TheZoq2/LiTHe-Hex/README.md

#LiTHe Hex
Our project for the course TSEA29
