TheZoq2/LiTHe-Hex/documents/TekniskDokumentation/images/flowchart_sensor.png

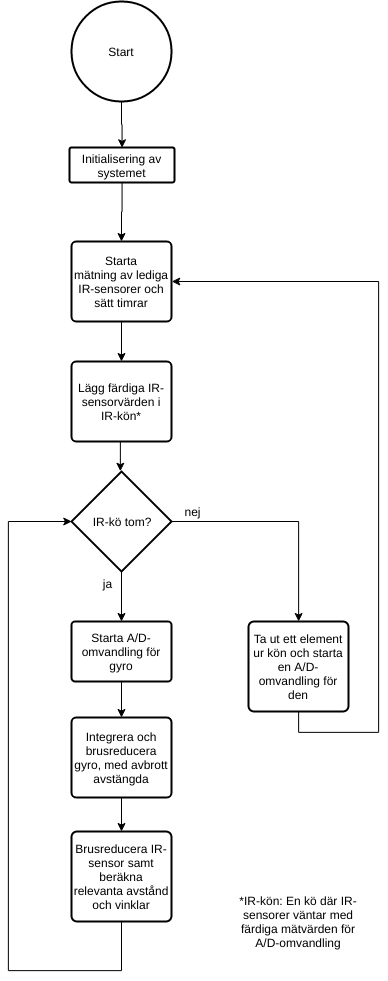
documents/TekniskDokumentation/images/flowchart_sensor.png
