TheZoq2/LiTHe-Hex/documents/TekniskDokumentation/images/IMG_20161005_120637.jpg

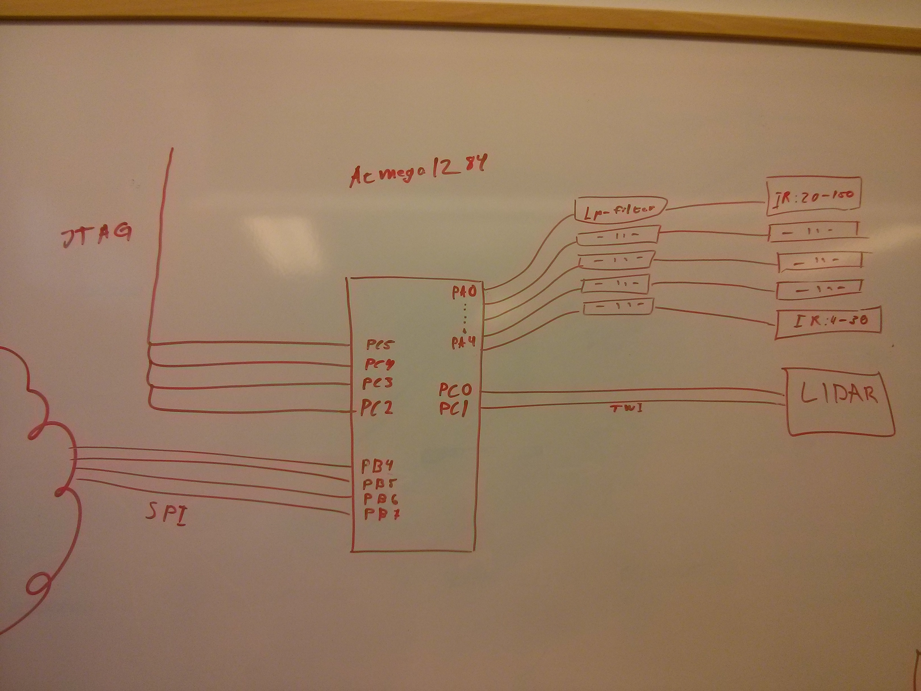
documents/TekniskDokumentation/images/IMG_20161005_120637.jpg
