TheZoq2/LiTHe-Hex/documents/TekniskDokumentation/images/IMG_20161006_112209.jpg

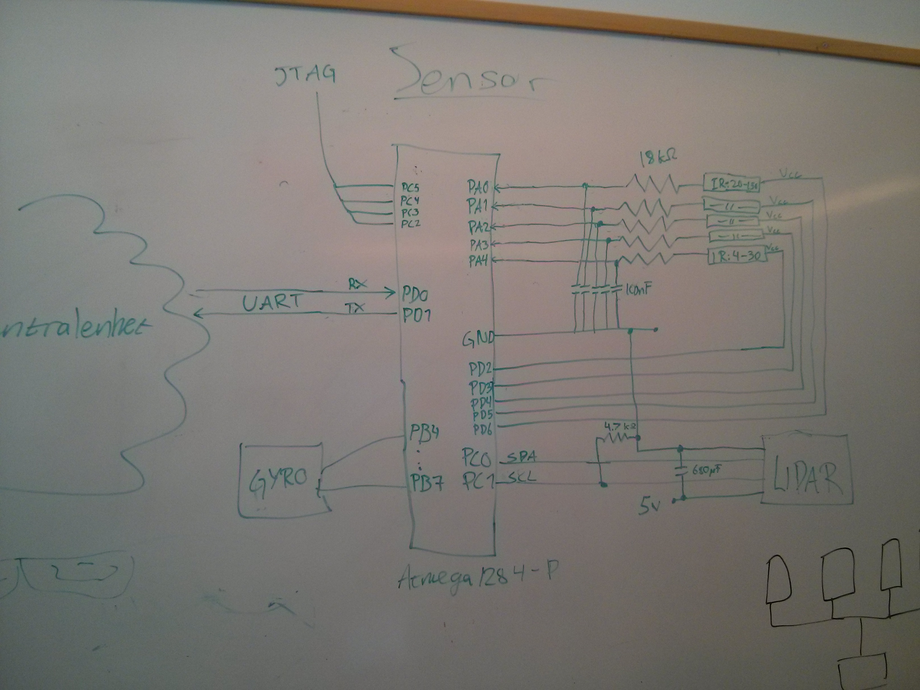
documents/TekniskDokumentation/images/IMG_20161006_112209.jpg
