TheZoq2/LiTHe-Hex/source/3d/alt sensormounts/sensormountFixed.stl

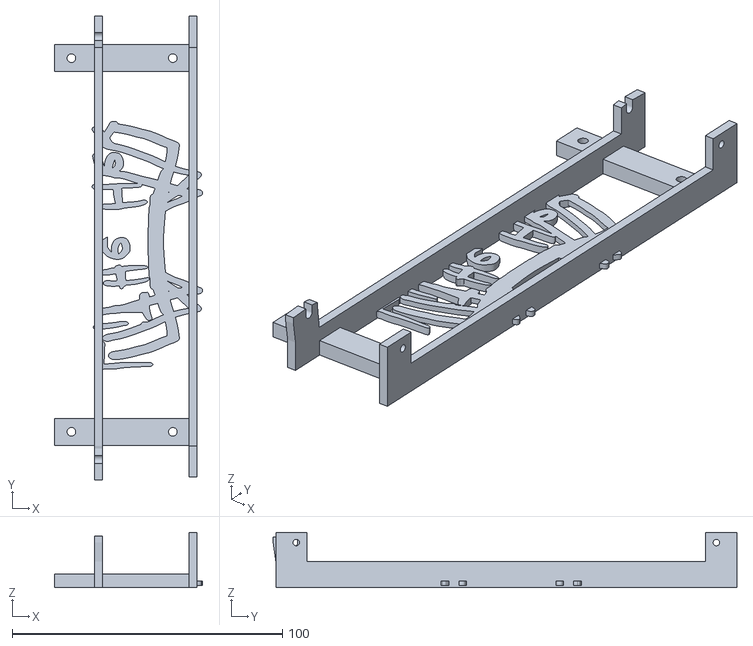
[picture p23: CAD file, 2016-12-06]
source/3d/alt sensormounts/sensormountFixed.stl
54.7 x 171.5 x 20.5
