TheZoq2/LiTHe-Hex/source/simulators/walk/media/cube.obj

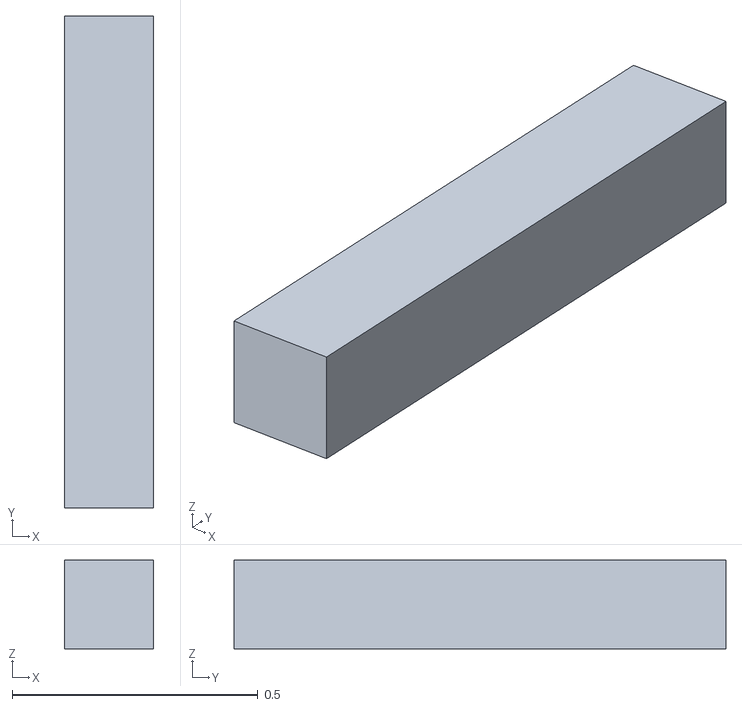
[picture p24: CAD file, 2016-10-11]
source/simulators/walk/media/cube.obj
0.181 x 1.00 x 0.181
