TheZoq2/LiTHe-Hex/source/3d/alt sensormounts/LOGO.stl

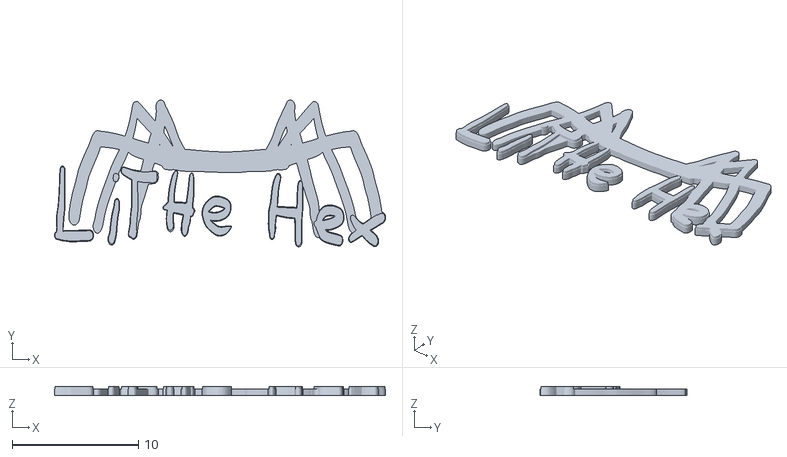
[picture p25: CAD file, 2016-12-06]
source/3d/alt sensormounts/LOGO.stl
26.2 x 11.6 x 0.7
