TheZoq2/LiTHe-Hex/source/3d/alt sensormounts/sensormount.obj

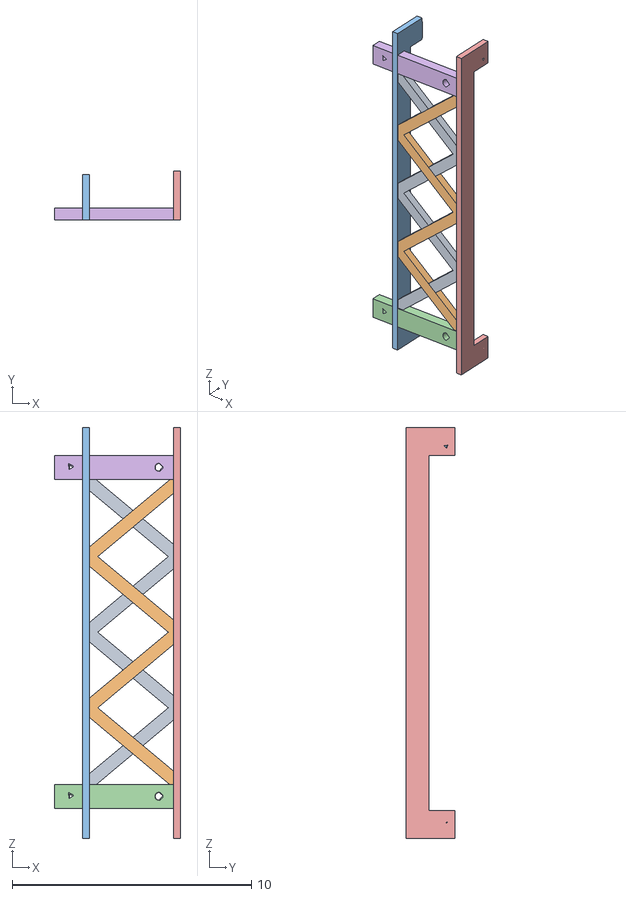
[picture p26: CAD file, 2016-11-30]
source/3d/alt sensormounts/sensormount.obj
5.28 x 2.05 x 17.2
Cube.001_Cube.003
Cylinder.003_Cylinder.002
Cylinder.002_Cylinder.003
