TheZoq2/LiTHe-Hex/(list of files, cad)

Other CAD files:
source/3d/alt sensormounts/sensormount.blend
