TheZoq2/LiTHe-Hex/documents/Anvandarmanual/anvman.tex

\documentclass[a4paper,titlepage,12pt]{article}
\usepackage[utf8]{inputenc} %Make sure all UTF8 characters work in the document
\usepackage{graphicx}
\usepackage{titling}
\usepackage{tabularx}
\usepackage{longtable}
\usepackage[yyyymmdd]{datetime}
\usepackage[figurename=Figur]{caption}
\usepackage{booktabs}
\usepackage[parfill]{parskip}
\usepackage{xcolor}
\usepackage{listings}
\usepackage{subcaption}

\lstdefinestyle{linux}
{
	backgroundcolor=\color{black},
	basicstyle=\scriptsize\color{white}\ttfamily
}

%Set page size
\usepackage{geometry}
\geometry{margin=3cm}

\renewcommand{\dateseparator}{-}
\renewcommand{\contentsname}{Innehållsförteckning}
\renewcommand{\tablename}{Tabell}

\usepackage{color}

\definecolor{dkgreen}{rgb}{0,0.6,0}
\definecolor{gray}{rgb}{0.5,0.5,0.5}
\definecolor{mauve}{rgb}{0.58,0,0.82}

\lstset{frame=tb,
  language=Python,
  aboveskip=3mm,
  belowskip=3mm,
  showstringspaces=false,
  columns=flexible,
  basicstyle={\small\ttfamily},
  numbers=none,
  numberstyle=\tiny\color{gray},
  keywordstyle=\color{blue},
  commentstyle=\color{dkgreen},
  stringstyle=\color{mauve},
  breaklines=true,
  breakatwhitespace=true,
  tabsize=3
}

%%%%%%%%%%%%%%%%%%%%%%%%%%%%%%%
% Header and footer
%%%%%%%%%%%%%%%%%%%%%%%%%%%%%%%
\usepackage{fancyhdr}
\pagestyle{fancy}

\lhead{}
\chead{Användarmanual för sexbent robot}
\rhead{\today}
\setlength\headheight{26pt} 

\lfoot{TSEA29 -- KMM \\ Användarmanual}
\rfoot{Grupp 9 \\ LiTHe Hex}

\newcommand{\itc}{I\textsuperscript{2}C}

\pretitle{%
	\begin{center}
		\LARGE
		\\[\bigskipamount]
}

\posttitle{\end{center}}

\begin{document}
	\title{\LARGE
		\textbf{Användarmanual för sexbent robot} \\
		\vspace*{0.5\baselineskip}
		\large
		Redaktör Frans Skarman \\
		Grupp 9 \\
		\small
		\vspace*{0.5\baselineskip}
		Version 1.0}

	\date{\today}

	\maketitle
	
	\newpage

	\tableofcontents
	\newpage

	%%%%%%%%%%%%%%%%%%%%%%%%%%%%%%%%%%%%%%%%%%%%%%%%%%%%%%%%%%%%%%%%%%%%%%%%%%%%%%%%%
	%						Historik
	%%%%%%%%%%%%%%%%%%%%%%%%%%%%%%%%%%%%%%%%%%%%%%%%%%%%%%%%%%%%%%%%%%%%%%%%%%%%%%%%%

	\section*{Dokumenthistorik}
	\renewcommand*{\arraystretch}{1.4}
    \begin{longtable}[c]{ l l >{\raggedright}p{5cm} >{\raggedright}p{3cm} l }
		\textbf{Version} & \textbf{Datum} & \textbf{Utförda förändringar} 
		& \textbf{Utförda av} & \textbf{Granskad} \\ \midrule
		
	    1.0 & 2016--12--14 & Första versionen & Projektgruppen &
        Projektgruppen \\
            
	\end{longtable}

	%%%%%%%%%%%%%%%%%%%%%%%%%%%%%%%%%%%%%%%%%%%%%%%%%%%%%%%%%%%%%%%%%%%%%%%%%%%%%%%%%
	%						Inledning
	%%%%%%%%%%%%%%%%%%%%%%%%%%%%%%%%%%%%%%%%%%%%%%%%%%%%%%%%%%%%%%%%%%%%%%%%%%%%%%%%%

	\newpage

	\raggedright

	\section{Inledning}
	Detta dokument beskriver användningen av LiTHe Hex magnifika sexbenta robot.

	%%%%%%%%%%%%%%%%%%%%%%%%%%%%%%%%%%%%%%%%%%%%%%%%%%%%%%%%%%%%%%%%%%%%%%%%%%%%%%%%%
	%						Översikt
	%%%%%%%%%%%%%%%%%%%%%%%%%%%%%%%%%%%%%%%%%%%%%%%%%%%%%%%%%%%%%%%%%%%%%%%%%%%%%%%%%
	
	\section{Roboten}
    Vid påslag av strömmen startar roboten alla system automatiskt.
    På roboten finns en knapp med vilken man kan byta mellan autonomt och
    manuellt läge.

	%%%%%%%%%%%%%%%%%%%%%%%%%%%%%%%%%%%%%%%%%%%%%%%%%%%%%%%%%%%%%%%%%%%%%%%%%%%%%%%%%
	%						Grafiskt användargränssnitt
	%%%%%%%%%%%%%%%%%%%%%%%%%%%%%%%%%%%%%%%%%%%%%%%%%%%%%%%%%%%%%%%%%%%%%%%%%%%%%%%%%

	\section{Grafiskt användargränssnitt}
	Här beskrivs hur man använder det grafiska användargränssnittet för roboten.
	
	\subsection{Starta webbservern}
    I vanliga fall ska webbservern på pi:en startas automatiskt av ett skript.
    I annat fall kan man göra det manuellt.
	Man startar servern genom att gå till mappen "/var/www/gui/" och skriva "mix
    phoenix.server". Se exempel nedan:
	
	\begin{lstlisting}[style=linux]
	/var/www/gui>> mix phoenix.server
	\end{lstlisting}
	
	\subsection{Ansluta till webbsidan}
	Servern startas på port 4000 och för att komma till webbsidan behöver man
    också pi:ens ip-adress. För att ta reda på Raspberry pi:ens ip-adress kan man gå in
    på telegram-kanalen https://telegram.me/lithehexbot. Det kräver dock att
    man har ett telegram-konto.
	
	Vi antar att ip-adressen är 127.0.0.1 och då skulle man i adressfältet i
    webbläsaren skriva 127.0.0.1:4000 för att komma till webbsidan.
    
    % TODO Är detta korrekt nedan?
    Det finns möjlighet att koppla in Raspberry pi till en skärm för att på så sätt ta reda på 
    vilken ip-adress som den har. 
	
	När man har anslutit till webbsidan finns det två olika flikar man kan välja
    mellan: Control och Debug. De beskrivs nedan i \ref{gui:control} och
    \ref{gui:debug}. Control är den första sidan som öppnas.
    \newpage
	
	\subsection{Control}\label{gui:control}
	\begin{figure}[h]
      \centering
      \begin{subfigure}{.4\textwidth}
        \centering
		
        \caption{Styrning för det manuella läget}
      \end{subfigure}
      \begin{subfigure}{.4\textwidth}
        \centering
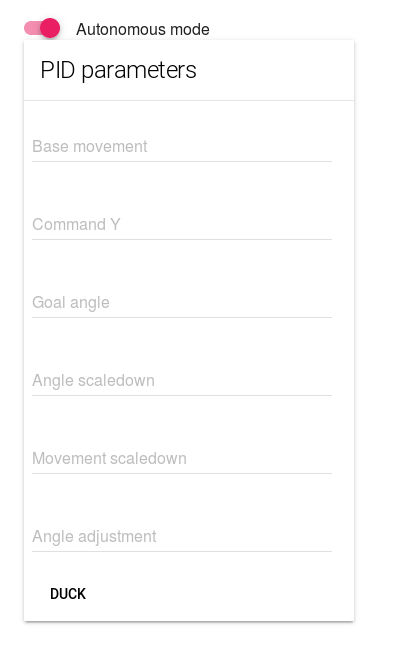
[picture p27: documents/Anvandarmanual/images/gui-parameters.png]
		
		\caption{Parametrar för det autonoma läget}
      \end{subfigure}
      \caption{Det grafiska gränssnittet för control\label{fig:gui-control}}
	\end{figure}
	
	När man har öppnat controlsidan antas det att en joystick är inkopplad i
    datorn. Om det finns en joystick inkopplad så kan man styra roboten med den.
    Om man drar joysticken åt ett håll rör sig roboten i den riktningen. En
    rotation av joysticken kommer göra att roboten roterar. På joysticken
    finns också ett gasreglage som styr hur snabbt roboten går och en
    återställningsknapp som gör att roboten återgår till sitt ursprungsläge och
    ställer sig upp igen.

    Om man inte har en joystick finns det olika reglage på skärmen man själv kan
    ändra: X- och Y-led, rotation samt thrust.
	
	Det finns en knapp som heter stop som stoppar roboten. Längst upp finns
    också en knapp för att välja mellan autonomt och manuellt läge. Manuellt
    läge är standardvärde. Se figur \ref{fig:gui-control} för att se hur webbsidan
    ser ut.
	
    \newpage
	\subsection{Debug}\label{gui:debug}
	\begin{figure}[h]
		\centering
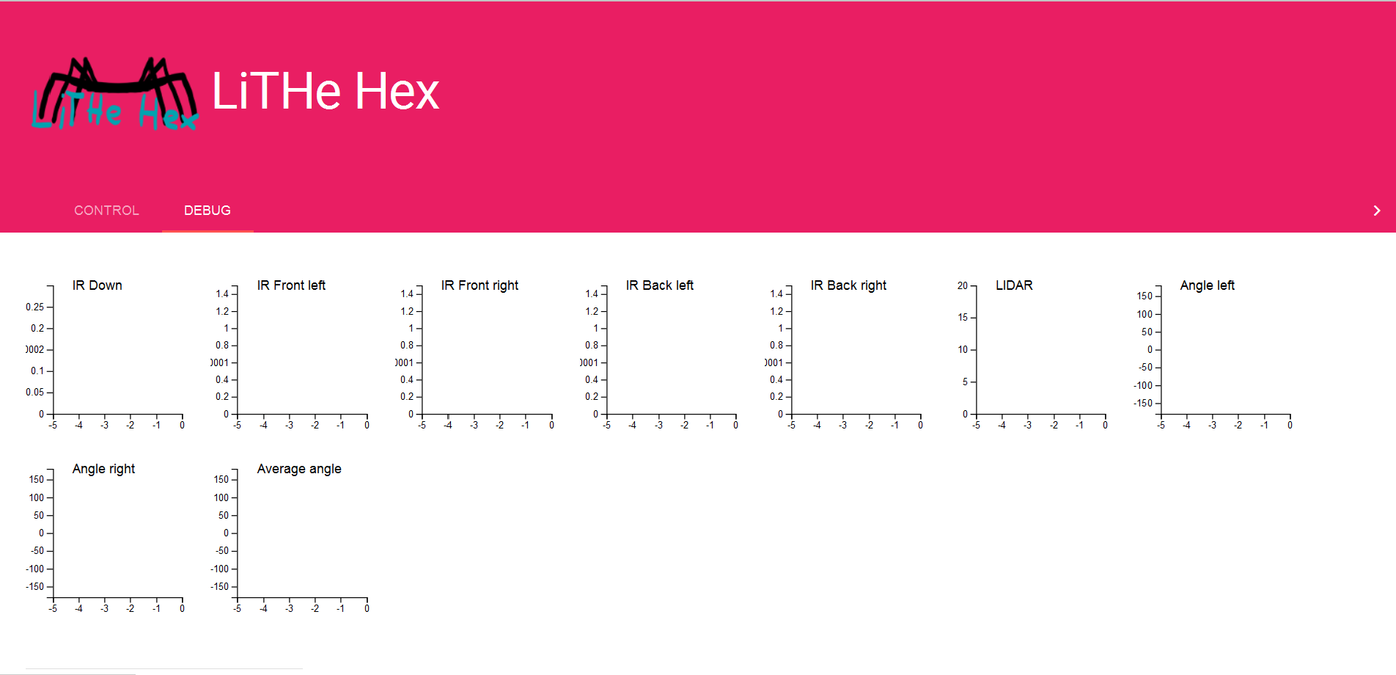
[picture p28: documents/Anvandarmanual/images/gui-debug.png]
		
		\caption{Det grafiska gränssnittet för control\label{fig:gui-debug}}
	\end{figure}
	När man öppnat debug fliken på hemsidan finns det nio stycken olika grafer som visar 
    olika sensordata för roboten vid det här tillfället. Graferna uppdateras tio
    gånger i sekunden för de nya värden som kommer in. Se figur
    \ref{fig:gui-debug} för hur debugsidan ser ut.
	
	% TODO: Ta med om man behöver uppdatera t.ex. phoenix eller liknande?

\end{document}
