TheZoq2/LiTHe-Hex/documents/Anvandarmanual/images/gui-front.png

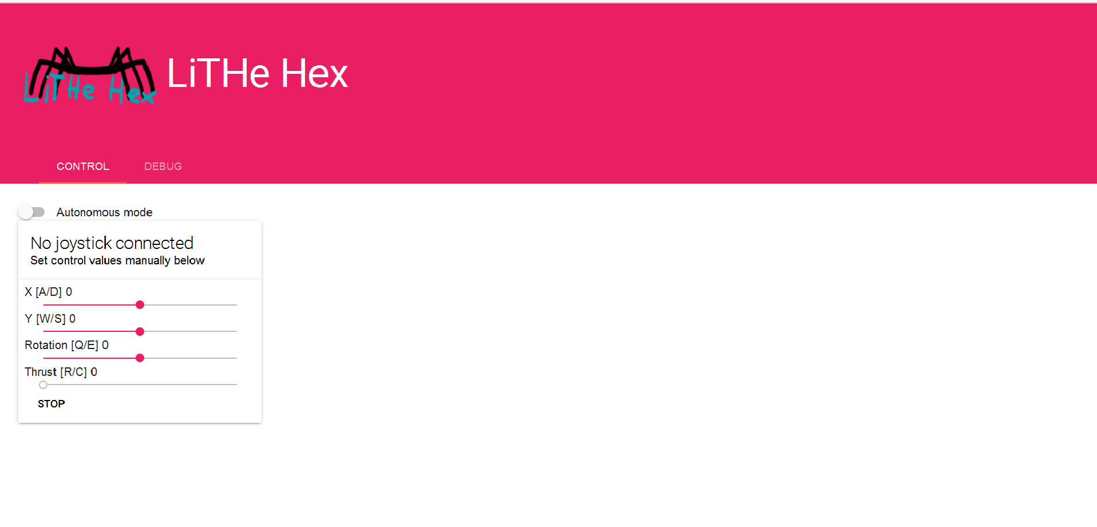
documents/Anvandarmanual/images/gui-front.png
