TheZoq2/LiTHe-Hex/source/sensor/measurements/measurements_ir.xlsx

Längd (cm) | Värde |  |  |  |  | Medel
20 | 505 | 510 | 505 | 510 | 504 | 506.8
30 | 390 | 395 | 394 | 391 | 391 | 392.2
40 | 300 | 301 | 300 | 303 | 300 | 300.8
50 | 239 | 243 | 246 | 246 | 243 | 243.4
60 | 207 | 207 | 209 | 204 | 200 | 205.4
70 | 173 | 174 | 176 | 173 | 174 | 174
80 | 152 | 156 | 155 | 152 | 152 | 153.4
90 | 136 | 140 | 135 | 135 | 140 | 137.2
100 | 126 | 122 | 126 | 121 | 127 | 124.4
110 | 113 | 112 | 113 | 112 | 112 | 112.4
120 | 105 | 104 | 103 | 104 | 104 | 104
130 | 97 | 96 | 95 | 95 | 95 | 95.6
140 | 89 | 87 | 87 | 86 | 88 | 87.4
150 | 83 | 83 | 83 | 85 | 83 | 83.4
Längd (cm) | Värde |  |  |  |  | Medel
4 | 551 | 550 | 550 | 559 | 549 | 551.8
6 | 406 | 399 | 399 | 405 | 406 | 403
8 | 315 | 310 | 310 | 315 | 311 | 312.2
10 | 235 | 252 | 252 | 257 | 252 | 249.6
12 | 210 | 210 | 209 | 210 | 212 | 210.2
14 | 179 | 179 | 179 | 186 | 179 | 180.4
16 | 155 | 159 | 156 | 159 | 159 | 157.6
18 | 140 | 142 | 143 | 140 | 141 | 141.2
20 | 122 | 123 | 123 | 123 | 123 | 122.8
22 | 112 | 112 | 111 | 111 | 111 | 111.4
24 | 103 | 105 | 103 | 103 | 103 | 103.4
26 | 91 | 95 | 89 | 93 | 92 | 92
28 | 88 | 87 | 89 | 89 | 89 | 88.4
30 | 79 | 76 | 81 | 79 | 76 | 78.2
 |  | 234
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
