TheZoq2/LiTHe-Hex/(threads)

Thread 14 (2016-11-30):

Impossible coordinates to IK should be dealt with

TheZoq2, 2016-11-30:

Kahiron, 2016-11-30:
@TheZoq2 If current code requests positions outside the reach of leg, adjusting constant MAX_DIST in gangstil should be sufficient to prevent this.

Closed 2016-11-30.

Thread 18 (2016-12-06):

Motor unit probably needs to reset rotation command after rotation.

malcx95, 2016-12-06:
Might rotate indefinitely otherwise.

Closed 2017-06-01.

Thread 19 (2016-12-11):

Things to try to get rid of SPI issues

TheZoq2, 2016-12-11:
- Disconnect servos (they caused issues before)
- Set CS enabled constantly (Might cause the transmission to fail because of weird hardware)
- Disconnect the sensors
- Disconnect all sensor hardware from sensor AVR (since avr disconnection solves the problem)
- Pull-up resistors on CS
- Check the datasheet for details on what the LVL shifter does with high-impedance and correct datadirection. (make sure it's connected propperly)

Debugging ideas
---
- Measure the voltage when everything is connected < 5V?
- Turn off some software things in the sensor unit

Closed 2016-12-12.
