TheZoq2/LiTHe-Hex/documents/Designspecifikation/images/flowchart_sensor.pdf

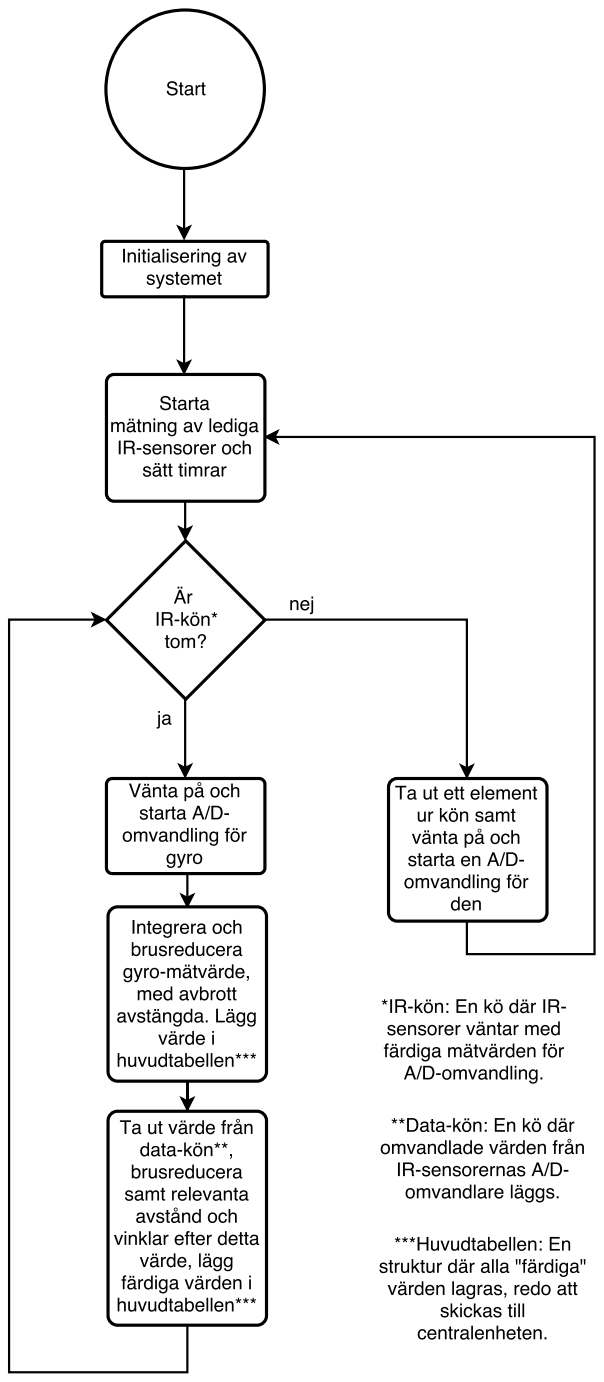
[picture p30: page 1]
