TheZoq2/LiTHe-Hex/documents/TekniskDokumentation/images/sensor_mount.pdf

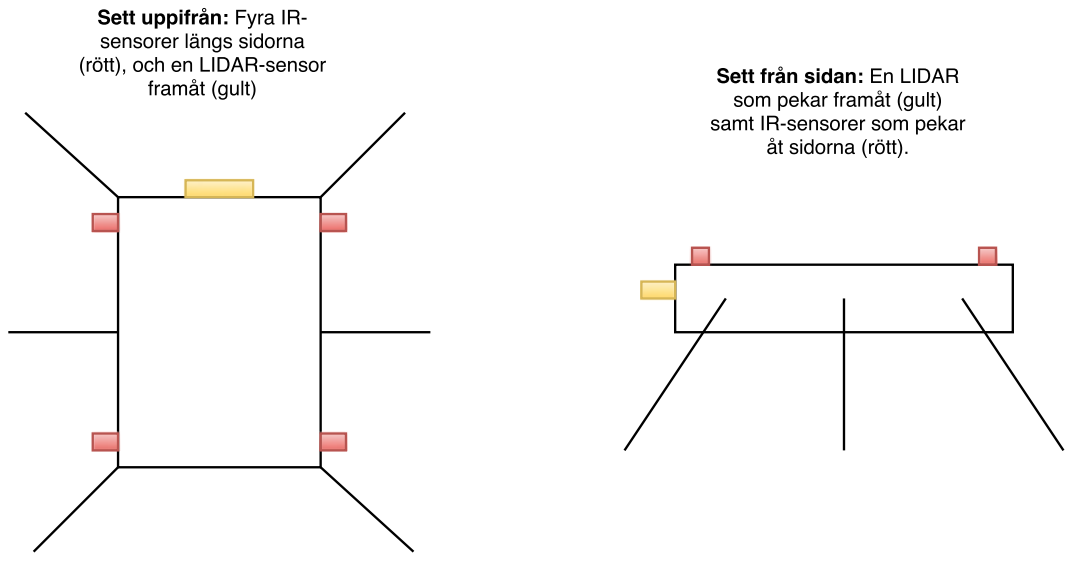
[picture p31: page 1]
