TheZoq2/LiTHe-Hex/documents/TekniskDokumentation/charts/central/centralenhet.pdf

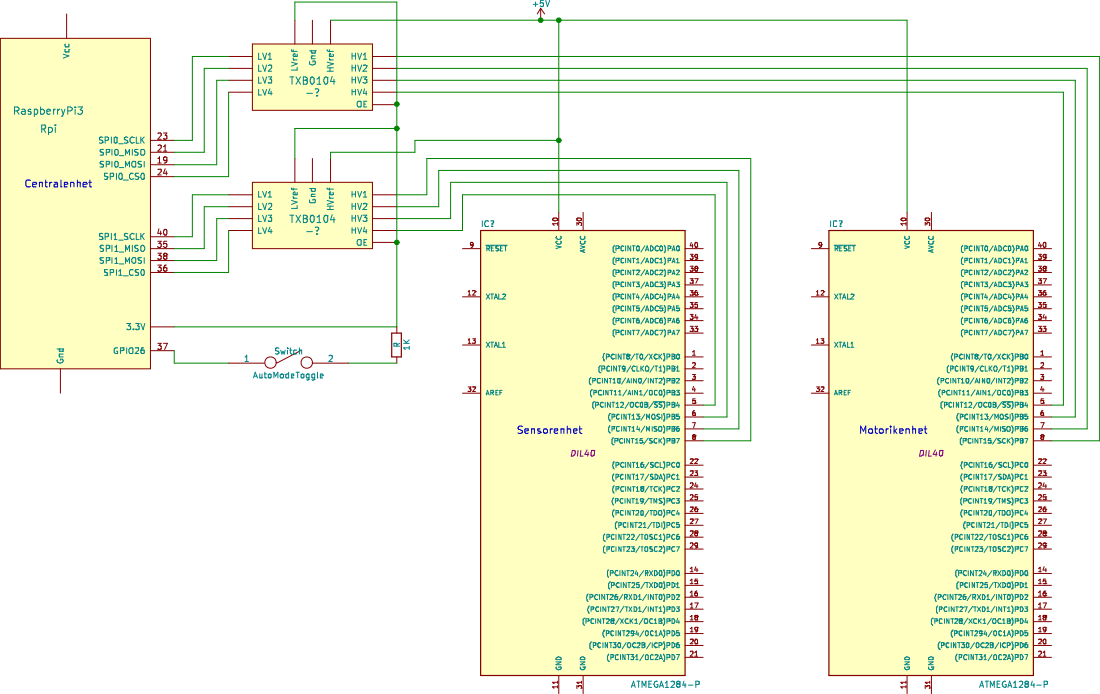
[picture p32: page 1]
