TheZoq2/LiTHe-Hex/documents/TekniskDokumentation/charts/sensor/sensor.pdf

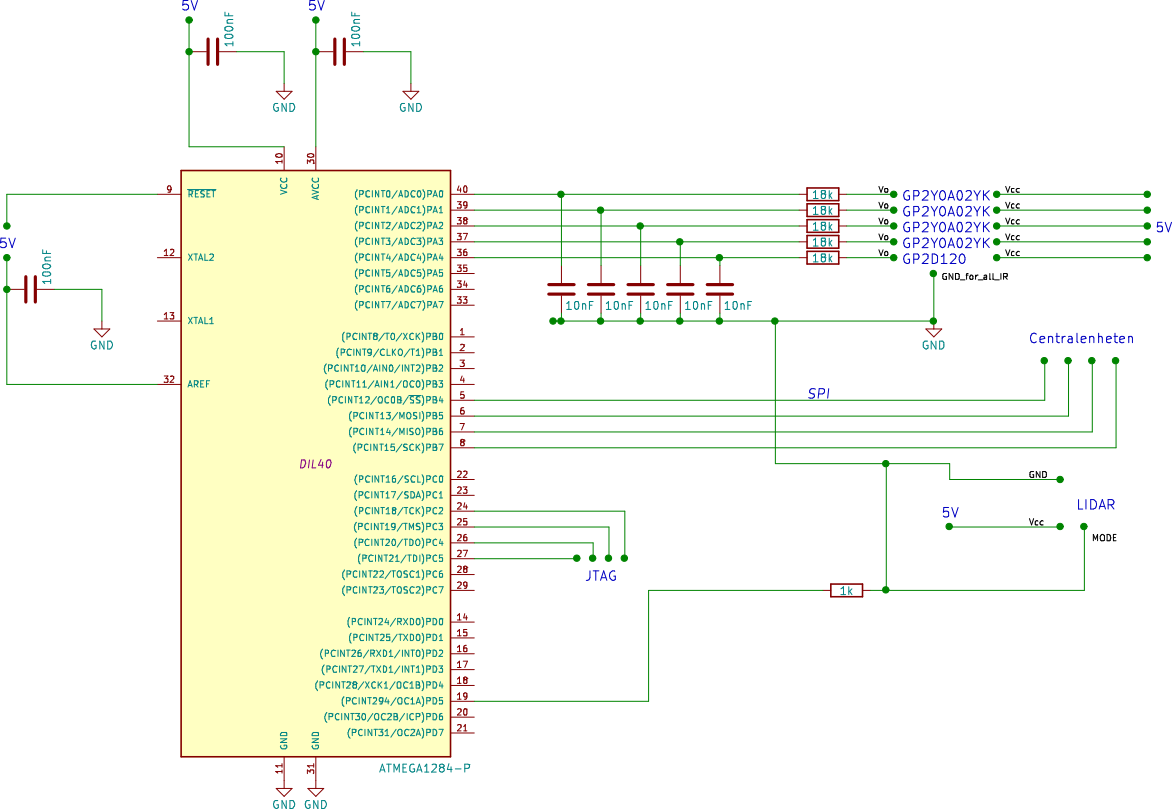
[picture p33: page 1]
