TheZoq2/LiTHe-Hex/documents/TekniskDokumentation/charts/motor/motorik.pdf

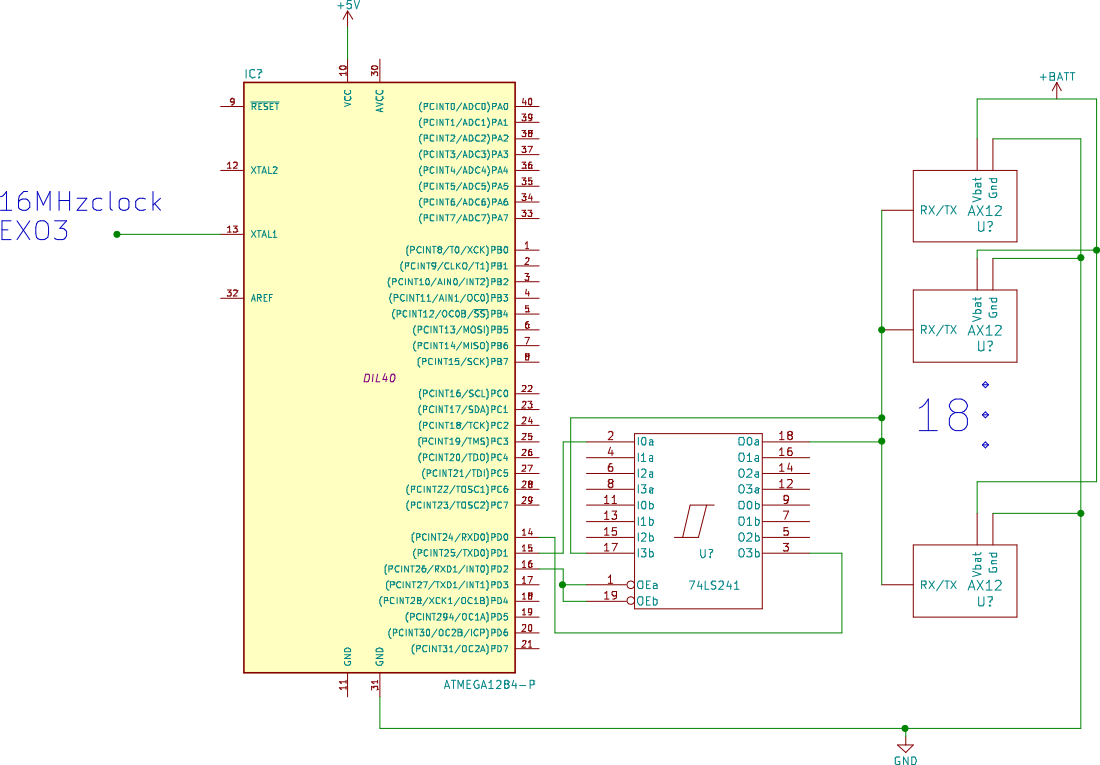
[picture p34: page 1]
