TheZoq2/LiTHe-Hex/source/central_unit/communication/avr_communication.py

# Copyright 2016 Noak Ringman, Emil Segerbäck, Robin Sliwa, Frans Skarman, Hannes Tuhkala, Malcolm Wigren, Olav Övrebö
#

# This file is part of LiTHe Hex.

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
"""
Module for handling communication with the sensor and motor units.
"""

try:
    import spidev
except ImportError:
    import tests.fake_spi as spidev

import time
import math
import angle_calculation
import pdb
import constants


MOTOR_ADDR = (0, 0)
SENSOR_ADDR = (1, 0)

DATA_REQ    = 0x02

SEND_FAIL   = 0x1F
ACK         = 0x0F
GARBAGE     = 0x00

BUSY_ROTATING = 0x03

SET_SERVO_SPEED = 0x20
SET_SERVO_SPEED_LENGTH = 2

WALK = 0x21
WALK_LENGTH = 4

RETURN_TO_NEUTRAL = 0x05

SERVO_STATUS = 0x22
MOTOR_DEBUG = 0x23

SENSOR_DATA = 0x24


class InvalidCommandException(Exception):

    def __init__(self, message, command=""):
        self.message = message
        self.command = command

    def __repr__(self):
        return self.message

    def __str__(self):
        return self.message


class CommunicationError(Exception):

    def __init__(self, message, cause=None):
        self.message = message
        self.cause = cause

    def __repr__(self):
        return self.message

    def __str__(self):
        return self.message


class SensorDataPacket(object):
    """
    Data structure containing the values of all sensors. All angles
    are measured in degrees and all distances in meters.
    """

    def __init__(self, ir_down, ir_front_left, ir_back_left,
                 ir_front_right, ir_back_right, lidar_msd, lidar_lsd):
        # divide by hundred to convert from cm -> m
        self.ir_front_left  = ir_front_left / 100
        self.ir_front_right = ir_front_right / 100
        self.ir_back_left   = ir_back_left / 100
        self.ir_back_right  = ir_back_right / 100
        self.ir_down        = ir_down / 100
        self.lidar          = (lidar_lsd | (lidar_msd << 8)) / 100
        self.left_angle     = angle_calculation.get_left_angle(self)
        self.right_angle    = angle_calculation.get_right_angle(self)
        self.average_angle  = angle_calculation.get_average_angle(self)

    def __str__(self):
        return """
Front left:  {}
Front right: {}
Back left:   {}
Back right:  {}
Down:        {}
Lidar:       {}
                """.format(
                        self.ir_front_left,
                        self.ir_front_right,
                        self.ir_back_left,
                        self.ir_back_right,
                        self.ir_down,
                        self.lidar)


def _calculate_parity(data):
    data_str = "{0:032b}".format(data)
    num_ones = data_str.count("1")
    if num_ones % 2 == 0:
        return 0
    else:
        return 1


def _add_parity(type_, msg):
    msg_parity = _calculate_parity(msg)
    result = type_ << 2
    result |= msg_parity << 1
    type_parity = _calculate_parity(result)
    result |= type_parity
    return result


def _send_bytes(spi, *data):
    # check if all are bytes
    if sum([(not isinstance(x, int)) or x > constants.MAX_BYTE_SIZE or x < 0 for x in data]):
        raise InvalidCommandException("Data sequence {} contains non-bytes".format(data))
    spi.writebytes([GARBAGE])
    spi.writebytes(list(data))
    return spi.readbytes(1)


def _recieve_muliple_bytes(spi, type_):
    length = spi.readbytes(1)[0]
    return spi.readbytes(length)


def _recieve_single_byte(spi, type_):
    return spi.readbytes(1)


def _recieve_bytes(spi):
    type_ = spi.readbytes(1)[0]

    # if the most significant bit in the
    # type message is 1, then the message
    # is of variable length
    if _is_multibyte_msg(type_):
        return _recieve_muliple_bytes(spi, type_)
    else:
        return _recieve_single_byte(spi, type_)


def _is_multibyte_msg(data_id):
    return (data_id & 0x80) != 0


def _request_data(spi, data_id):
    # response = spi.xfer2([DATA_REQ, data_id])
    # pdb.set_trace()
    response = _send_bytes(spi, _add_parity(DATA_REQ, data_id), data_id)
    _check_response(response)
    return _recieve_bytes(spi)


# def _select_device(spi, addr):
#     spi.open(*addr)
# 
# 
# def _deselect_device(spi):
#     spi.close()


def _check_response(response):
    if isinstance(response, list):
        _check_response(response[0])
    elif response == SEND_FAIL:
        raise CommunicationError("Send fail received")
    elif response != ACK:
        raise CommunicationError("No acknowledge message received")


def _get_total_msg(*data):
    length = len(data)
    res = ""
    for d in data:
        res += "{0:08b}".format(d)
    return int(res, 2)


def sensor_communication_init():
    """
    Initializes the SPI-communication to the
    sensor unit.
    """
    spi = spidev.SpiDev()
    spi.open(*SENSOR_ADDR)
    spi.max_speed_hz = 25000
    return spi


def motor_communication_init():
    spi = spidev.SpiDev()
    spi.open(*MOTOR_ADDR)
    spi.max_speed_hz = 25000
    return spi


def set_servo_speed(spi, speed, timeout=None):
    """Sets the global servo speed on the motor unit"""
    count = 0
    while True:
        try:
            if speed < 0 or speed > constants.MAX_16BIT_SIZE:
                raise InvalidCommandException("Speed \"{}\" is not a 16-bit value"
                                              .format(speed))
            least = speed & 0x00FF
            most = (speed & 0xFF00) >> 8
            total_msg = _get_total_msg(SET_SERVO_SPEED_LENGTH, least, most)
            response = _send_bytes(spi, _add_parity(SET_SERVO_SPEED, total_msg),
                                   SET_SERVO_SPEED_LENGTH, least, most)
            _check_response(response)
            print("")
            print("Sent speed: " + str(speed))
            break
        except CommunicationError:
            count += 1
            time.sleep(0.01)
            if timeout is not None and count == timeout:
                print("Timeout reached after {} tries".format(count))
                return
            print("Tried sending speed (times): " + str(count), end="\r")


def walk(spi, x_speed, y_speed, turn_speed, auto_mode, timeout=None):
    """
    Commands the motor unit to walk in the direction and speed 
    given by x_speed, y_speed and turn_speed
    """
    count = 0
    while True:
        try:
            auto = 0x01 if auto_mode else 0x00
            total_msg = _get_total_msg(WALK_LENGTH, x_speed, y_speed, turn_speed, auto)
            response = _send_bytes(spi, _add_parity(WALK, total_msg),
                           WALK_LENGTH, x_speed, y_speed, turn_speed, auto)
            _check_response(response)
            print("Walk sent x: {}, y: {}, r: {}".format(x_speed, y_speed, turn_speed))
            break
        except CommunicationError:
            count += 1
            time.sleep(0.01)
            if timeout is not None and count == timeout:
                print("Timeout reached after {} tries".format(count))
                return
            print("Tried sending walk (times): " + str(count), end="\r")


def back_to_neutral(spi, timeout=None):
    """Commands the motor unit to return to the neutral state"""
    # we send a zero byte as args
    count = 0
    while True:
        try:
            response = _send_bytes(spi, _add_parity(RETURN_TO_NEUTRAL, 0), 0)
            _check_response(response)
            print("Back to neutral sent")
            break
        except CommunicationError:
            count += 1
            time.sleep(0.01)
            if timeout is not None and count == timeout:
                print("Timeout reached after {} tries".format(count))
                return
            print("Tried sending back to neutral (times): " + str(count), end="\r")


def is_busy_rotating(spi, timeout=None):
    """
    Asks the motor unit whether it's busy rotating. Stops asking
    if an optional given timeout is reached, at which point it
    returns True, since the motor unit is busy if it doesn't respond.
    """
    count = 0
    while True:
        time.sleep(0.01)
        try:
            raw_data = _request_data(spi, BUSY_ROTATING)
            print("Sucessfully asked motor whether busy rotating")
            return bool(raw_data[0])
        except CommunicationError:
            count += 1
            if timeout is not None and count == timeout:
                print("Timeout reached after {} tries".format(count))
                # we can assume the motor unit is busy if it doesn't respond
                return True
            print("Tried asking motor unit whether busy (times): " +
                  str(count), end="\r")


def get_sensor_data(spi):
    """
    Gets the values of all sensors in the sensor unit,
    and puts them in a SensorDataPacket.
    """
    count = 0
    while True:
        time.sleep(0.01)
        try:
            raw_data = _request_data(spi, SENSOR_DATA)
            sensor_data = SensorDataPacket(*raw_data)
            return sensor_data
        except Exception as e:
            count += 1
            print("Tried getting sensor_data ({}) (times): ".format(str(e)) +
                  str(count), end="\r")
