TheZoq2/LiTHe-Hex/source/central_unit/communication/web.py

# Copyright 2016 Noak Ringman, Emil Segerbäck, Robin Sliwa, Frans Skarman, Hannes Tuhkala, Malcolm Wigren, Olav Övrebö

# This file is part of LiTHe Hex.

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
import threading
import time
try:
    import pika
except ImportError:
    pass
import json

CENTRAL_UNIT_KEY_RECEIVE = 'to_pi'
CENTRAL_UNIT_KEY_SEND = 'from_pi'

QUEUE_CHECK_DELAY = 0.001


class ServerReceivedPacket(object):
    """
    Data structure containing the information of parsed JSON-strings
    from the web server. Fields are marked None if the particular key
    was not included in this message.
    """

    def __init__(self, json_string):
        """
        Construct a ServerReceivedPacket from a json string
        """
        data = json.loads(json_string)
        self.raw = data
        self.x = data.get('x', None)
        self.y = data.get('y', None)
        self.rotation = data.get('rotation', None)
        self.thrust = data.get('thrust', None)
        self.auto = data.get('auto', None)
        self.base_movement = data.get('base_movement', None)
        self.command_y = data.get('command_y', None)
        self.goal_angle = data.get('goal_angle', None)
        self.angle_scaledown = data.get('angle_scaledown', None)
        self.movement_scaledown = data.get('movement_scaledown', None)
        self.angle_adjustment_border = data.get('angle_adjustment_border', None)
        self.return_to_neutral = data.get('reset', None)


        # if we got x, then we should have gotten everything else
        if self.x is not None:
            assert (self.y is not None and
                    self.rotation is not None and
                    self.thrust is not None)

    def has_motion_command(self):
        return self.x is not None


class ServerSendPacket(object):
    """
    Data structure containing information to be converted to JSON-strings
    and sent to the web server.
    """

    def __init__(self, sensor_data_packet=None, 
                 auto_mode=None, debug_string=None):
        """
        Constructs a ServerSendPacket from an optional SensorDataPacket,
        an optional flag indicating whether automatic
        mode is engaged, and an optional debug-string.
        """
        assert auto_mode is None or auto_mode in (True, False)
        assert debug_string is None or isinstance(debug_string, str)
        self.sensor = sensor_data_packet
        self.auto_mode = auto_mode
        self.debug_string = debug_string
    
    def get_json(self):
        data = {}
        if self.sensor is not None:
            data["ir_down"] = self.sensor.ir_down
            data["ir_fl"] = self.sensor.ir_front_left
            data["ir_fr"] = self.sensor.ir_front_right
            data["ir_bl"] = self.sensor.ir_back_left
            data["ir_br"] = self.sensor.ir_back_right
            data["lidar"] = self.sensor.lidar
            data["angle_l"] = self.sensor.left_angle
            data["angle_r"] = self.sensor.right_angle
            data["angle_avg"] = self.sensor.average_angle
        if self.auto_mode is not None:
            data["auto"] = self.auto_mode
        if self.debug_string is not None:
            data["debug"] = self.debug_string
        return json.dumps(data)


class ServerSenderThread(threading.Thread):
    """
    Thread whose job is to send packets put in the send queue
    to the server. Dequeues an element (if available) and sends
    it 1/QUEUE_CHECK_DELAY times per second.
    """

    def __init__(self, queue, channel, connection):
        super().__init__()
        self.queue = queue
        self.channel = channel
        self.connection = connection

    def run(self):
        """
        Loop and wait QUEUE_CHECK_DELAY seconds. 
        """
        while True:
            if not self.queue.empty():
                packet = self.queue.get()
                self.channel.basic_publish(exchange='', 
                                           routing_key=CENTRAL_UNIT_KEY_SEND,
                                           body=packet.get_json())
            time.sleep(QUEUE_CHECK_DELAY)


class ServerReceiverThread(threading.Thread):
    """
    Thread whose job is to receive packets from the server and put
    in the receive queue.
    """

    def __init__(self, queue, channel, connection):
        super().__init__()

        def _receive_callback(ch, method, properties, body):
            self.queue.put(ServerReceivedPacket(body.decode("utf-8")))

        self.queue = queue
        self.channel = channel
        self.connection = connection
        self.channel.basic_consume(_receive_callback,
                                   queue=CENTRAL_UNIT_KEY_RECEIVE,
                                   no_ack=True)

    def run(self):
        self.channel.start_consuming()


class CommunicationThread(threading.Thread):
    """
    The main communication thread which is started in the background. Creates
    a thread that sends data packets put in the shared send queue to the
    web server, and another thread that receives data from the web server and 
    puts it in the shared receive queue.
    """

    def __init__(self, send_queue, receive_queue):
        super().__init__()

        # setup connection
        connection = pika.BlockingConnection(pika.ConnectionParameters(host='localhost'))

        # create the send and receive channels
        channel_receive = connection.channel()
        channel_send = connection.channel()
        channel_receive.queue_declare(queue=CENTRAL_UNIT_KEY_RECEIVE)
        channel_send.queue_declare(queue=CENTRAL_UNIT_KEY_SEND)

        # create the send and receive threads
        self.receive_thread = ServerReceiverThread(receive_queue, channel_receive, 
                                                   connection)
        self.send_thread = ServerSenderThread(send_queue, channel_send, connection)

    def run(self):
        # start the threads
        self.receive_thread.start()
        self.send_thread.start()

        # wait for the threads to stop (should never happen)
        self.receive_thread.join()
        self.send_thread.join()
