TheZoq2/LiTHe-Hex/source/motor/motorik/uart_lib.h

#ifndef H_UART_LIB
#define H_UART_LIB

#include "avr_helper.h"

#ifndef IS_X86
#include <avr/io.h>
#include <avr/interrupt.h>
#include <util/delay.h>
#endif

#include <stdint.h>

enum UsartDirection
{
	RX,
	TX
};

void usart_init();
void uart_wait();
void usart_transmit(uint8_t data);
uint8_t usart_receive();
void usart_set_direction(enum UsartDirection direction);
void clear_uart_buffer();

#endif
