TheZoq2/LiTHe-Hex/source/motor/motorik/status.c

#include "status.h"
#include <math.h>

#define BIT_OFFSET  127
#define MAX_16_BIT  65535

float uint8_to_float(uint8_t original)
{
	//return (float)((int8_t)original - BIT_OFFSET) / BIT_OFFSET;
	float data_float = (((float)original)/255.0) * 2.0 - 1.0;
	return roundf(data_float * 100) / 100;
}

void status_init(volatile CurrentStatus* status) {
    status->x_speed = 0.0;
    status->y_speed = 0.0;
    status->rotation = 0.0;
	status->is_rotating = false;
    status->servo_speed = 0.0;
    status->return_to_neutral = false;
    status->auto_mode = false;
	status->servo_speed = false;
}

void status_set_speed(volatile CurrentStatus* status, uint8_t x_speed, uint8_t y_speed) {
    status->x_speed = uint8_to_float(x_speed);
    status->y_speed = uint8_to_float(y_speed);
}

void status_set_rotation(volatile CurrentStatus* status, uint8_t rotation) {
    status->rotation = uint8_to_float(rotation);
}

void status_set_servo_speed(volatile CurrentStatus* status, uint8_t speed_lsb, uint8_t speed_msb) {
    status->servo_speed = (uint16_t)(speed_lsb | (speed_msb << 8));
}
