TheZoq2/LiTHe-Hex/source/motor/motorik/avr_helper.h

#include <stdio.h>

#ifdef IS_X86

#include <stdio.h>
#include <stdint.h>

#define PORTA 'A'
#define PORTB 'B'
#define PORTC 'C'
#define PORTD 'D'

#define DDRD 'D'



#endif
