TheZoq2/LiTHe-Hex/(commit log)

2016-09-05 Add motor controller description to kravspec
2016-09-09 Change sensor requirements for central unit
2016-09-19 Wrote Motorikenhet
2016-09-19 Revert "Wrote Motorikenhet"
    This reverts commit 3e4bd4ef6a9c6c86a86c276111790ace25859015.
2016-09-19 Re-added motorikdel
2016-09-19 Wrote most of sensors
2016-09-19 Wrote sensors
2016-10-05 Wrote on motorikenhet
2016-10-05 Removed some options on sensors
2016-10-06 Add image of sensorenheten
2016-10-06 Add image of sensorenheten, wrote some text under sensorenheten
2016-10-06 Add image of sensorenheten, wrote some text under sensorenheten, again
2016-10-06 Add note how to handle sensor data
2016-10-06 Changed some stuff on sensors
2016-10-10 Start working on walk simulator
    [cube.obj]
2016-10-10 Add buggy inverse kinematic simulator
2016-10-12 Fixed Frans shitty spelling and filenames
    [main.py]
2016-10-12 Wrote some on sensorenhet and Simulering för korridorföljning
2016-10-12 Created most of the sensor's chart
    [sensor.sch]
2016-10-12 Added flowchart for obstacle traversal.
2016-10-13 Added flowchart for fancy-pansy robot walk.
2016-10-13 wrote a few lines in motorikenhet
2016-10-13 Rewrote some on sensorenhet...
2016-10-13 wrote a few lines on motorikenhet
2016-10-13 Pretty much finished sensor chart
    [sensor.sch]
2016-10-19 Change interrupts under sensors
2016-10-19 Finished sensor chart
    [sensor.sch]
2016-10-19 Added sensor flowchart
2016-10-19 added flowcharts to actual document, fixed some sh*t.
2016-10-19 referenced flowcharts in motorikenhet
2016-10-20 Added sensor mount chart
2016-10-20 fixed my sh*tty text, fixed flowchart
2016-10-20 Add raggedright, viva la revulotuon
2016-10-20 Added sensor mount image
2016-10-31 Added schematics image
2016-11-01 Did some work on leg simulator
2016-11-02 Move sensor kicad file to separate directory
    [sensor.sch]
2016-11-02 Fixed sensor unit
2016-11-02 Add some circuit diagrams
    [motor.kicad_pcb, motor.sch, motorik.kicad_pcb, motorik.sch]
2016-11-02 Add missing circuit diagrams
2016-11-02 Add sensor unit schematic as pdf
2016-11-02 Fixed some sensor stuff
2016-11-07 add sensor to source map
2016-11-07 Change side view to show side of leg instead of robot from behind
2016-11-07 Added adc
2016-11-07 Added some adc config
2016-11-07 Added adc conversion and wrote simple test
2016-11-07 ADC now works
2016-11-07 Add Haskell bindings to IK for QuickCheck testing
    [ik.c]
2016-11-08 Separated into front- and back sensors.
2016-11-08 Added error signal and started implementing ir_queue
    [ir.h, ir_queue.c, ir_queue.h]
2016-11-08 use the ir_queue for schedule ir sensors
2016-11-08 Added a missing gpl notice
    [adc.c]
2016-11-10 Added timer
2016-11-10 Implemented timer
2016-11-10 Added error.c and updated main
    [sensor.c]
2016-11-10 wrote some on decision making and removed magic constants in pid controller
2016-11-10 Added measurements
    [measurements_ir.xlsx]
2016-11-10 Add eq to measurements
    [measurements_ir.xlsx]
2016-11-10 Get sensor data in meter
    [measurements_ir.xlsx]
2016-11-14 started on gyro
2016-11-14 fix code for gyro
    [sensor.c]
2016-11-14 Fixed gyro name
2016-11-14 Add more than one leg to leg simulator
2016-11-14 Add missing leg file
    [leg.rs]
2016-11-14 Add leg angle output
2016-11-14 Wrote gyro measure
2016-11-14 Add leg offset
2016-11-14 Added lidar
2016-11-15 fix timer and working on gyro
    [sensor.c, timer.c, timer.h]
2016-11-15 Added some functions in lidar
2016-11-15 Implemented some of the lidar and i2c functions
2016-11-15 implement functions for read/write lidar
2016-11-15 Add missing lib file
    [motorik.sch]
2016-11-15 Fix designspec issues
    [motor.sch, motorik.sch]
2016-11-15 Cropped centralenhet schematics
    [motor.sch]
2016-11-16 Add some motor test code
2016-11-17 Added pwm implementation of lidar
2016-11-17 LIDAR working and timers tooooo
2016-11-17 Add some servo test code
2016-11-17 added spi reciever code
2016-11-17 Added technical documentation
    [motor.kicad_pcb, motor.sch, motorik.kicad_pcb, motorik.sch, sensor.sch]
2016-11-17 lidar and ir done on sensor unit
2016-11-17 added python code for writing with spi
2016-11-17 Test UART on motorikenhet
2016-11-17 Change servo instruction to ping
2016-11-18 added spi-reciever c code
2016-11-18 Added gågstil
    Code still messy/undergoing testing. Temporarily using std.io to read file results.
    Immediate todo:
    -divide into .c and .h files
    -iron out any remaining bugs
    -add code to take in instructions, execute leg movement
    -adjust start value
    -create final program flow (currently the actual functions only exist and are run for testing )
    -Switch over to avr.io, integrate with rest of project
    [main.c]
2016-11-18 Test UART code
2016-11-18 wrote some tekdok and some spi
2016-11-18 Some work on getting UART servos to work
2016-11-18 Try to fix some servo communication things
    [motorik.c]
2016-11-21 worked on gånstil
    buggfixes, cleanup of code, etc. Calculation works as intended; will
    proceed to work on higher level algorithm flow.
    [main.c]
2016-11-21 Wrote spi
2016-11-21 Got some servo communication working
2016-11-22 fixed spi
2016-11-22 Test servo communication code
2016-11-22 Make avr send reset command
    [motorik.c]
2016-11-22 Try sending servo data at the startof the program
2016-11-22 Try setting the angle limit of the servos
2016-11-22 fixed my sh*tty code
    [main.c]
2016-11-23 Mov servo code into separate file
2016-11-23 Add a servo map
2016-11-23 fixed spi some more
    [communication.c, communication.h, spi.c, spi.h]
2016-11-24 fix magic const and add spi_fail
    [communication.c, communication.h, spi.c, spi.h]
2016-11-24 Moved set trace
2016-11-24 Add some more servo code
2016-11-24 Add servo.c and h file to atmel project
2016-11-24 Make servo commands use the action feature
2016-11-24 Fixed incorrect response checking
    [communication.py]
2016-11-24 Fixed set servo speed
    [communication.py]
2016-11-24 Added servo speed test
2016-11-24 Try limiting servo speed
2016-11-24 The shit is not working
    [communication.py, main.py]
2016-11-24 Removed an error check
    [communication.py]
2016-11-24 Try some leg movement code
2016-11-24 fixed path issue in gangstil.h
    [gangstil.h]
2016-11-24 test new version of SPI
2016-11-24 Add comments to the servo header file
2016-11-24 Try adding a delay to make all servos work
2016-11-24 Fix servo 10 not moving
    [servo.c]
2016-11-24 added servo control to gangstil.c
2016-11-24 spi works now probably, maybe
2016-11-24 moved and merged the written files to correct folder
    [communication.c, communication.h, spi.c, spi.h]
2016-11-24 fixed offset of joints
    [ik.h]
2016-11-25 Fixed merge conflict again
    [communication.c]
2016-11-25 sensor com. work great
2016-11-25 done more testing and found a bug to fix another beautiful day
    [communication.py, main.py]
2016-11-27 Added data structures for the sensor data and wrote docstrings
2016-11-27 fixed spi communication error on paj side
    [communication.py, main.py]
2016-11-27 Reversed lidar order and fixed indentation
    [communication.py]
2016-11-27 Add beginning of sensor mounts
2016-11-27 changed to use real sensor data
2016-11-28 add communication and spi to motorik
2016-11-28 Add servo rely code
2016-11-28 Add delay to servo communication
2016-11-28 Add code for sensor data diagrams
2016-11-28 Add some servo code
2016-11-28 Try making servos work
2016-11-28 Added threads for sending and receiving
2016-11-28 Test some servo stuff
2016-11-28 fix data to send to centraluint
    [table.c, table.h]
2016-11-28 Test a bunch of things related to servos
2016-11-28 Added json parsing and test case
2016-11-28 Fixed test case
2016-11-28 decision making and pid controlling now works with real sensor data
2016-11-29 fix angle in sensor and wrote some tekdoc
    [sensor.c, table.c]
2016-11-29 Fixed leg height.
2016-11-29 Added unittest and fixed some things
    [unittests.py, web.py]
2016-11-29 Added unit tests for closing a thread and creating an empty packet
2016-11-29 angle is now calculated in central unit instead of sensor unit
2016-11-29 added sensor mounts
    [sensormount.blend, sensormount.obj]
2016-11-29 Removed kravspec duplicates and communication test case
2016-11-29 fix sensor and angle
    [ir.c, sensor.c, table.c]
2016-11-29 Fix Olavs shitty code
    [gangstil.c, gangstil.h, motorik.c]
2016-11-30 Updated sensormounts, rescaled and remodeled.
    [sensormount.blend, sensormount.obj]
2016-11-30 fixed errors in central unit
    [decision_making.py]
2016-11-30 Add unit testing framework
2016-12-01 Removed spi test stuff
2016-12-01 Add function for converting from robot to servo coordinates
2016-12-01 Created testing infrastructure for spi communication
2016-12-01 Added some working spi unittests
2016-12-01 Added tests for testing the sensor reading in the manual mode
2016-12-01 added button and mode changingto central unit GPIOHYPE!
2016-12-01 Fix robot to servo coordinate conversion
    [gangstil.c, gangstil.h, unit.c]
2016-12-02 add send_decision to motor, not done. add take in regulate parameters from server
2016-12-02 add sceleton for send command from auto mode to motor and some communication to server
2016-12-02 Some minor changes to servo communication
2016-12-02 Fix floating point conversion
    [status.c, unit.c]
2016-12-02 fixed smooth stepping during walk.
    [gangstil.c]
2016-12-02 Fix servo replys
2016-12-02 Make send_servo_action block until servos are done moving
2016-12-02 Fix segmentation fault and make uart compile on x86
    [servo.c, uart_lib.c]
2016-12-03 Add multiple sensor diagrams
2016-12-03 Add customization of sensor ranges
2016-12-05 Add code for customization of PID parameters
2016-12-05 Fixed bug preventing sideways movement in gangstil
    [gangstil.c]
2016-12-06 added new sensor mount, logo
    [LOGO.stl, sensormountFixed.stl]
2016-12-06 Added unittest that fails
    [main.py, unittests.py]
2016-12-06 Add fields for PID parameters
2016-12-06 fixed nonworking code in main
    [main.py]
2016-12-06 fixed wrong code making main unrunnable
    [decision_making.py, main.py]
2016-12-06 Rewrite servo done check
2016-12-06 Added motor busy message to tekdoc
2016-12-06 Fix leg movement delay
    [servo.c]
2016-12-06 Fix bug with sensor value display. HEJJAGARHANNESNU:)
2016-12-06 Start working on buttons to use when there is no joystick
2016-12-06 Added debug prints
2016-12-07 Fixed rotation issue
    rotate_set_angle now works as it should, legs behave more reliably.
    [gangstil.c]
2016-12-08 prevented leg movement for still standing robot
    [gangstil.c]
2016-12-08 com. motor
2016-12-08 add interrupts
2016-12-08 Add some simple error handling
    [servo.c, servo.h]
2016-12-08 Add spi boilerplate for x86
2016-12-08 Fix servo communication issues
    [motorik.c, servo.c]
2016-12-08 fix servo issues
2016-12-08 add spi.close
2016-12-08 Add auto button
2016-12-08 Fix Raise to default position
    [gangstil.c, uart_lib.c]
2016-12-08 Added two separate spi objects for each unit
2016-12-08 Added debug prints and better way of receiving packets
2016-12-08 Fixed unittests for manual mode
    [unittests.py]
2016-12-08 Revert "Remove a malloc call"
    This reverts commit 63e914618c8f89d0b31c1f0ab87467cabc6f6fcd.
    [motorik.c, servo.c, servo.h, servo_x86.c]
2016-12-08 Fix memory leak on x86 systems
    [servo.c, servo_x86.c]
2016-12-08 Fix some compiler warnings
    [gangstil.c, motorik.c, servo.c, servo.h]
2016-12-09 Fix all the bugs
    [motorik.c, servo.c]
2016-12-09 Found broken walk input
    [motorik.c]
2016-12-09 Add test case for tornado
2016-12-09 Fixed tornado, but I didn't fix it myself
    [gangstil.c, motorik.c, servo.c]
2016-12-10 Add message sent for reset button
2016-12-10 Add servo angle return values from server
2016-12-10 Forgot to remove some code used in testing, fixed.
    [gangstil.c]
2016-12-12 wrote some on tekdok, motorikenhet
2016-12-12 Updated central unit chart and unit tests
    [motor.sch]
2016-12-12 Fixed last conflict better
    [main.py]
2016-12-12 Removed ik folder, ik is in motorik now
2016-12-13 changes to motorunit
2016-12-13 Added motor spi in decisions
2016-12-13 try timer in sensor
2016-12-13 Add current sensor values
2016-12-13 Make current_status volatile
2016-12-13 Remove unnecesairy timer
2016-12-13 wrote on tekdok, motorik
2016-12-13 Fixed memory leak/unnecesary code
    [gangstil.c]
2016-12-13 Fix some minor issues
    [leg.rs, motorik.c, servo.c, spi_x86.c]
2016-12-13 Interrupts and stuffs
2016-12-13 Debug prints
2016-12-13 Added pid to movement
2016-12-13 Add text about servo communication
2016-12-13 Add cap to pid controller angle
2016-12-13 temporary fix of bothersome scaledown of rotation.
    [gangstil.c]
2016-12-13 fixed typo, renamed variables
    [gangstil.c]
2016-12-13 think this code works fine for motor and sensor
2016-12-13 added text about physical mode change button
2016-12-13 add pseudo code for sensor and remove unused code
2016-12-13 Updates sensor chart
    [sensor.sch]
2016-12-14 Updated central unit
    [motor.sch]
2016-12-14 Resize schematic for motor unit
2016-12-14 updated gangstil flowchart
2016-12-14 clarified some things in motorikdelen, tekdok.
2016-12-14 Updated some images and sensor section
2016-12-14 made small adjustments to motorikenhet in tekdok
2016-12-14 Addeed sensor mount
2016-12-14 fixed todos in motorikdel, tekdok
2016-12-14 Resize schematics
2016-12-14 fixed(?) bothersome behaviour resulting of prior bugfix
    [gangstil.c]
2016-12-14 legs should normalize over time
2016-12-14 Removed debug prints
2016-12-14 leg position correction modable by const
    [gangstil.c]
2016-12-14 Fix strange merge conflict
    [motorik.c, servo.c]
2016-12-15 Scaling only applied to raised legs, should
2016-12-15 rewrote some of pid controller
2016-12-15 fix set servo speed
    [servo.c, status.c]
2016-12-15 Servo speed change works in manual mode
2016-12-15 attempted fix for servo read freeze
    [servo.c, uart_lib.c, uart_lib.h]
2016-12-15 Add reset button to control interface without joystick
2016-12-15 Added fix for some commands being ignored
    [main.py]
2016-12-15 Attempted fix for tornado bug
    [gangstil.c, motorik.c]
2016-12-15 Frans's fuckugly fix, after his first didn't work.
    [gangstil.c]
2016-12-15 pid controller WORKSgit status lol, kidding.
2016-12-16 Change LIDAR range to 5
2016-12-16 Make rotation change the other way, set default thrust to 1 and stop resetting of thrust
2016-12-16 Add servo ID change function
2016-12-16 Add stop rotation button
2016-12-18 added potential speedup, to be tested. Moves raised legs further.
2016-12-20 Add text about weird servo responses
2016-12-20 remove print and add some comment
2016-12-20 remove gyro code
